sudo-junkie/GeoLock/README.md

# GeoLock

KiCad 7 design files (schematic, PCB, BOM, gerbers) for an STM32F103-based car tracker with the following features:

-	USB-C - firmware upload & debugging
-	Relay - for engine cutout
-	NEO-6M GPS - location tracking
-	SIM800C GSM - for text-based killswitch and location reporting
-	SD Card - location logging and saving persistent settings/data

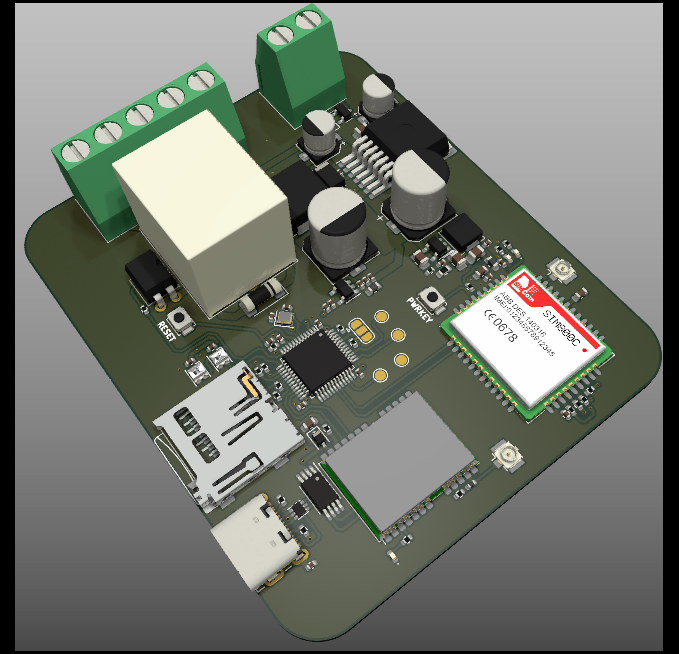
[picture p1: IMAGES/GeoLock5.png]


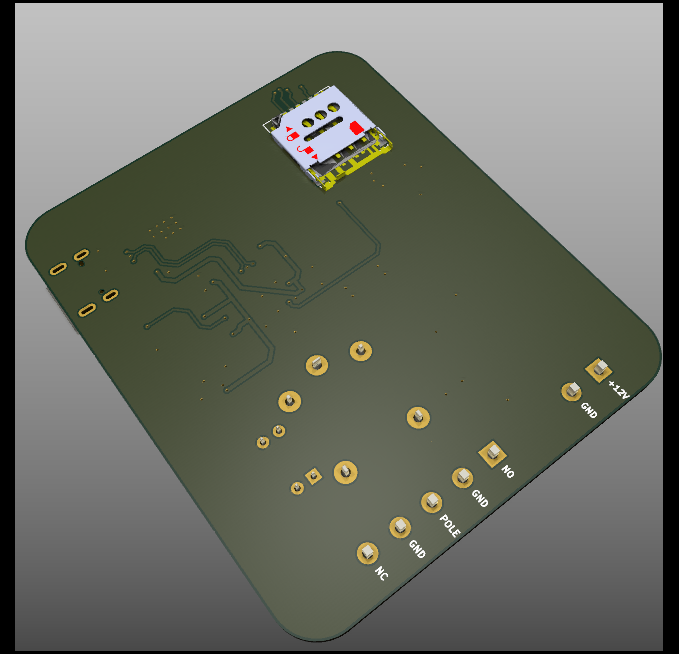
[picture p2: IMAGES/GeoLock6.png]


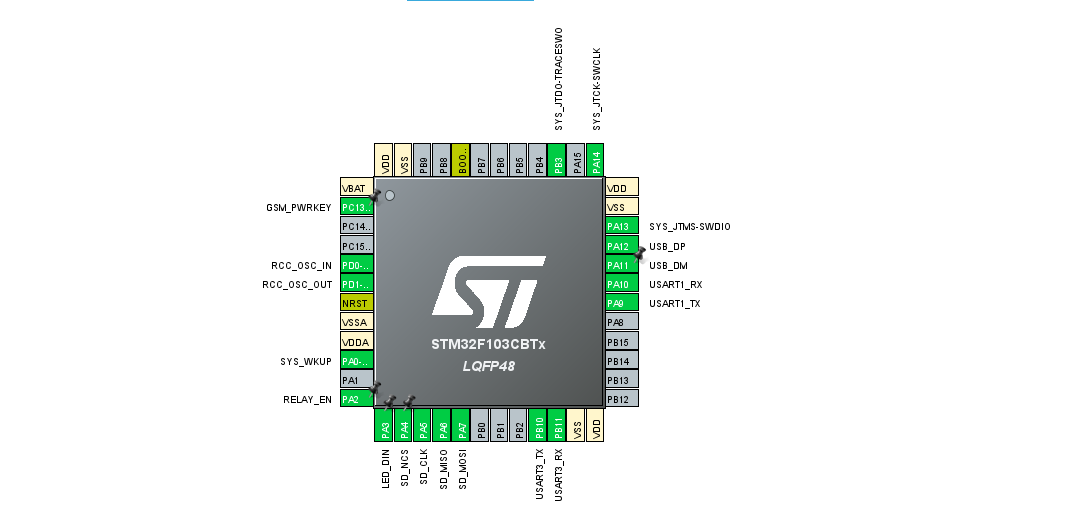
[picture p3: IMAGES/GeoLock_CubeMX.png]
