sudo-junkie/GeoLock/IMAGES/GeoLock2.png

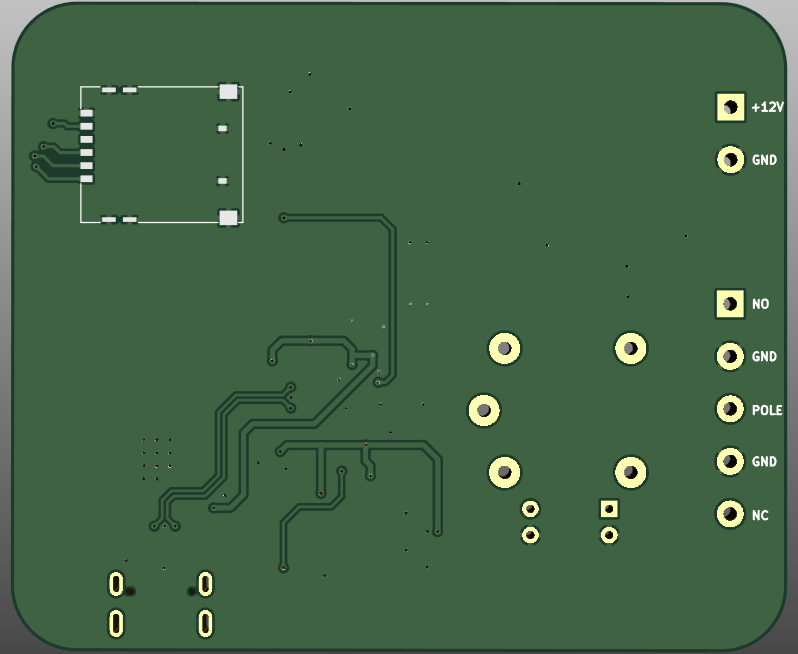
IMAGES/GeoLock2.png
