sudo-junkie/GeoLock/IMAGES/GeoLock3.png

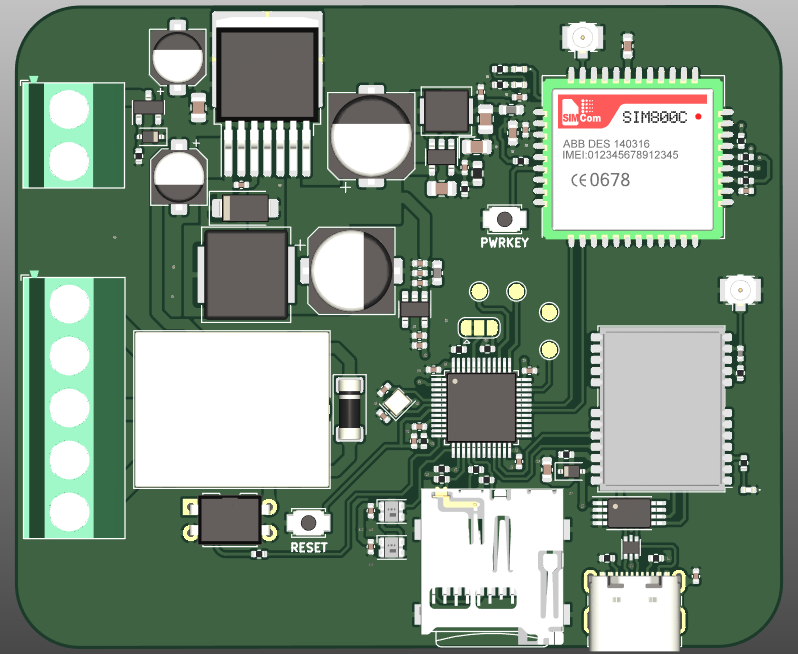
IMAGES/GeoLock3.png
