sudo-junkie/GeoLock/IMAGES/GeoLock4.png

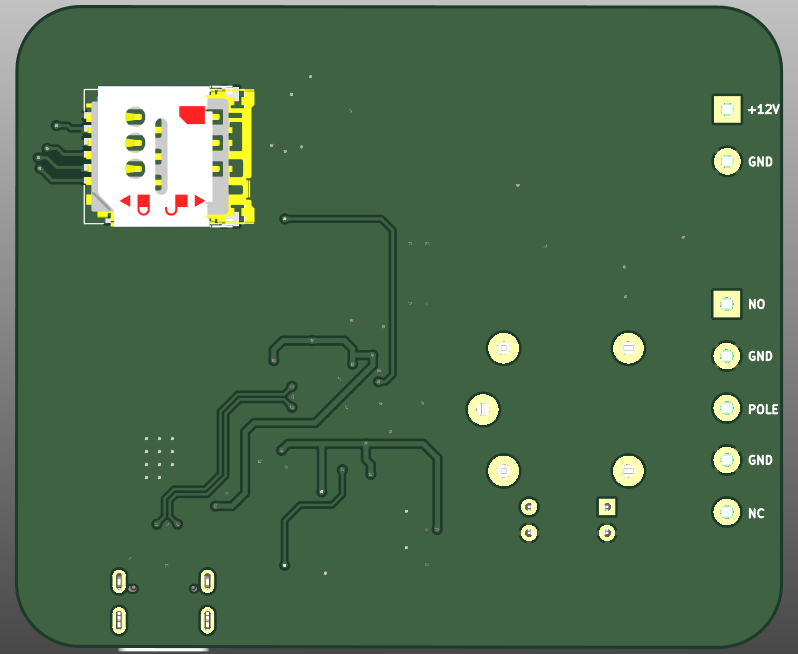
IMAGES/GeoLock4.png
