sudo-junkie/GeoLock/IMAGES/GeoLock7.png

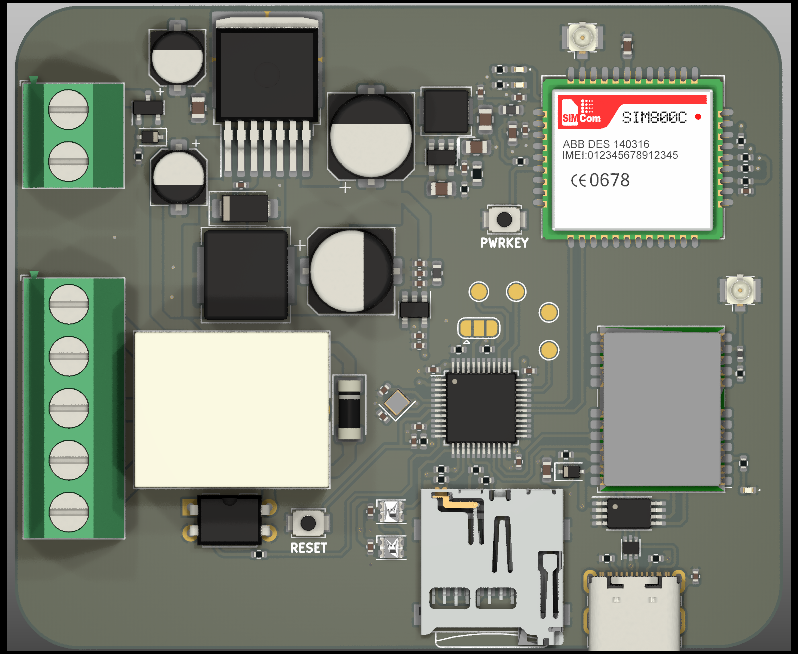
IMAGES/GeoLock7.png
