sudo-junkie/GeoLock/IMAGES/GeoLock8.png

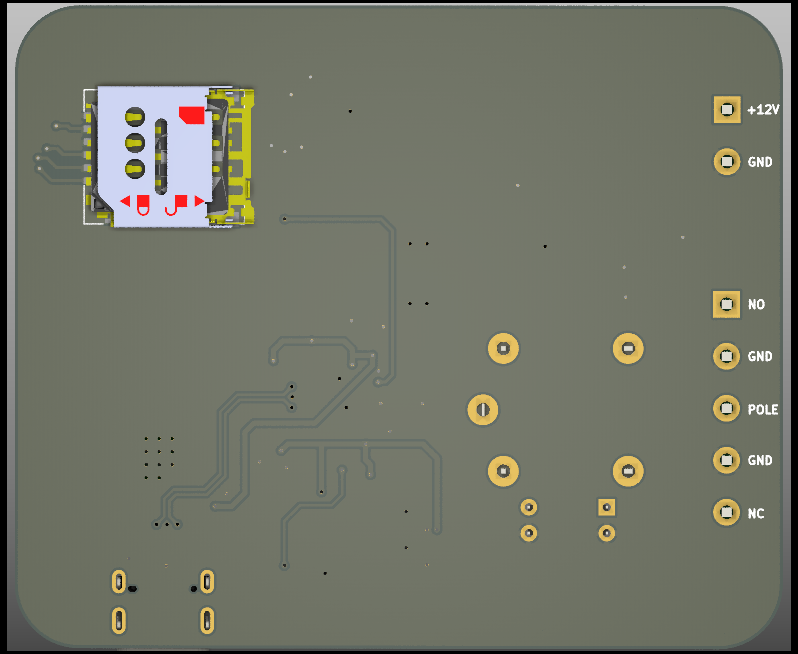
IMAGES/GeoLock8.png
