sudo-junkie/GeoLock/IMAGES/GeoLock.png

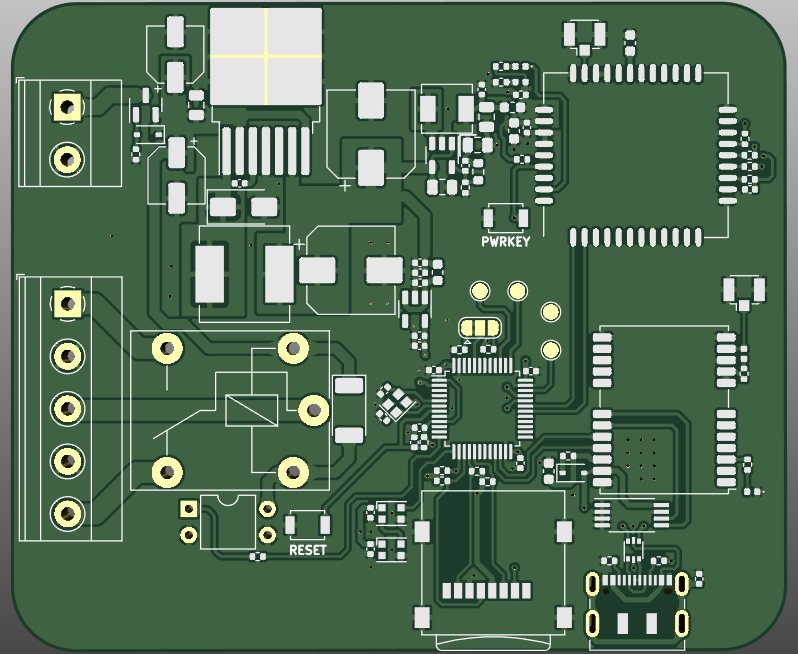
IMAGES/GeoLock.png
