sudo-junkie/GeoLock/SRC/GeoLock.kicad_pcb

## KiCad design SRC/GeoLock.kicad_pcb (2023-06-28)

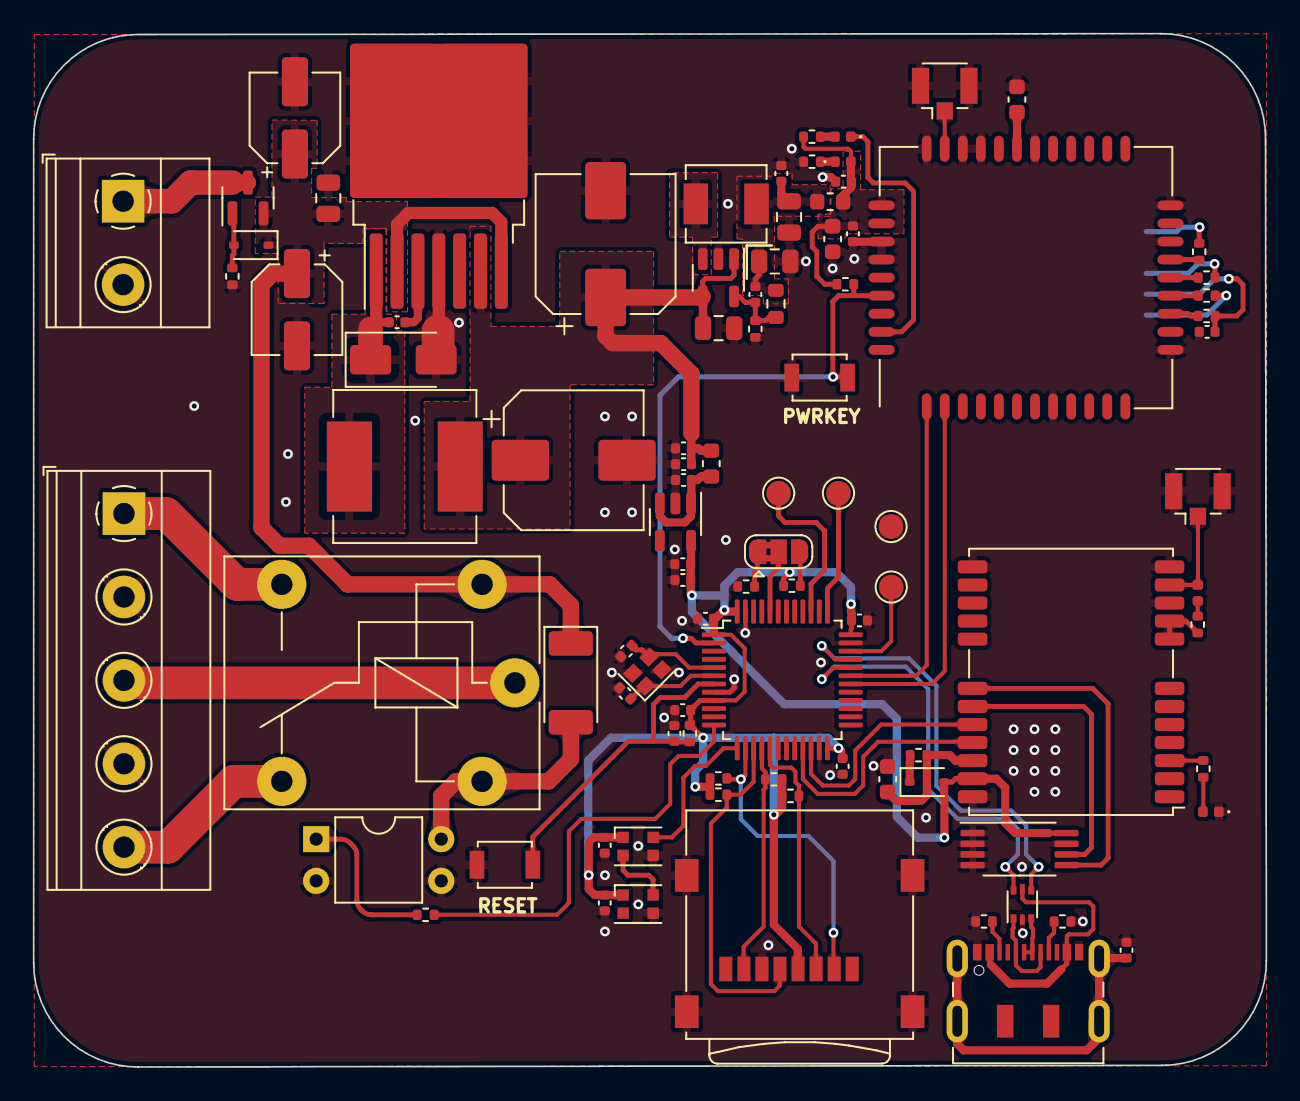
[picture p16: board GeoLock.kicad_pcb from above]

Board: 2 copper layers, 75.1 x 62.9 mm, 95 parts (1 on the bottom side), 69 nets.

Parts:
C101, C207, C409, C410, C508, C509, C510: 1u 10% 10V X5R; C_0402_1005Metric
C203: 10u 20% 10V X5R; C_0402_1005Metric
C204, C205, C206, C210, C211, C404, C507, C511: 100n 10V 5%; C_0402_1005Metric
C208, C209: 22p 1% NP0 50V; C_0402_1005Metric
C401, C403, C601: 100u 20% 6.3V; C_0603_1608Metric
C402, C408: 8p ±1% 50V C0G; C_0402_1005Metric
C405, C406, C407: 22u 20% X5R 16V; C_0805_2012Metric
C501: 10n 5% 16V X7R; C_0402_1005Metric
C502, C503: 22u 20% 50V; CP_Elec_5x5.8
C504: 470n 5% 50V X7R; C_0805_2012Metric
C505, C506: 180u 20% 50V; CP_Elec_8x10
D101: 11V; D_SOD-323
D201, D202: WS2812B; LED_WS2812B-2020_PLCC4_2.0x2.0mm
D301: SM4001; D_MELF
D401: GSM_PWR; LED_0402_1005Metric
D402: GSM_NET; LED_0402_1005Metric
D501: SS54; D_SMA
D601: SD103AWS; D_SOD-323
D602: LED_GPS; LED_0402_1005Metric
FB401, FB501: 220R @ 100MHz 3A; L_0603_1608Metric
J101: Conn_VIN; TerminalBlock_Phoenix_MKDS-1,5-2-5.08_1x02_P5.08mm_Horizont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
J102: Conn_CUTOUT; TerminalBlock_Phoenix_MKDS-1,5-5-5.08_1x05_P5.08mm_Horizont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
J103: USB_C_Receptacle_USB2.0; USB_C_Receptacle_JAE_DX07S016JA1R1500
J201: Micro_SD_Card; microSD_HC_Wuerth_693072010801
J401: SIM_Card; microSIM_JAE_SF53S006VCBR2000
J402: Conn_GSM; U.FL_Hirose_U.FL-R-SMT-1_Vertical
J601: Conn_GPS; U.FL_Hirose_U.FL-R-SMT-1_Vertical
JP201: JP_BOOT; SolderJumper-3_P1.3mm_Bridged2Bar12_RoundedPad1.0x1.5mm
K301: FINDER-36.11; Relay_SPDT_Finder_36.11
L401: 2u2; L_Sunlord_MWSA0402S
L501: 22u; L_Sunlord_MWSA0804S
L601: 22u; L_0402_1005Metric
Q101: AO3401A; SOT-23
R101, R201, R202, R203, R204, R205, R206, R207, R407: 10K 0.1%; R_0402_1005Metric
R102, R103: 5K1 0.1%; R_0402_1005Metric
R301, R602: 1K 0.1%; R_0402_1005Metric
R401: 330K 0.1%; R_0603_1608Metric
R402: 56K 0.1%; R_0402_1005Metric
R403, R404, R405, R406: 51R 0.1%; R_0402_1005Metric
R408, R603: 4k7 0.1%; R_0402_1005Metric
R409: 4K7 0.1%; R_0402_1005Metric
R601: 22R 0.1%; R_0402_1005Metric
SW201: SW_RST; SW_SPST_B3U-1000P
SW401: GSM_PWR; SW_SPST_B3U-1000P
TP201: TP_SWCLK; TestPoint_Pad_D1.5mm
TP202: TP_GND; TestPoint_Pad_D1.5mm
TP203: TP_SWO; TestPoint_Pad_D1.5mm
TP204: TP_SWDIO; TestPoint_Pad_D1.5mm
U101: USBLC6-2P6; SOT-666
U201: STM32F103CBTx; LQFP-48_7x7mm_P0.5mm
U301: PC817; DIP-4_W7.62mm
U401: SY8089; SOT-23-5
U402: SIM800C; SIMCom_SIM800C
U501: LM2678-5.0; TO-263-7_TabPin8
U502: TLV75733PDBV; SOT-23-5
U601: NEO-6x; ublox_NEO
U602: 24LC32; TSSOP-8_4.4x3mm_P0.65mm
Y201: 16MHz; Crystal_SMD_2016-4Pin_2.0x1.6mm

Connections:
+3V3: C203.1, C204.1, C205.1, C206.1, C210.1, C211.1, C510.1, C511.1, D201.1 (VDD), D202.1 (VDD), D601.2 (A), J201.4 (VDD), R201.1, R202.1, R203.1, R204.1, R205.1, R206.1, U201.1 (VBAT), U201.9 (VDDA), U201.24 (VDD), U201.36 (VDD), U201.48 (VDD), U502.5 (OUT), U601.23 (VCC), U602.8 (VCC)
+4V: C403.2, C404.1, C410.1, D401.2 (A), FB401.1, R407.1, R408.2, U402.34 (VBAT), U402.35 (VBAT)
+5V: C405.1, C505.1, C506.1, C507.1, C508.1, FB501.1, L501.2, U401.1 (EN), U401.4 (VIN), U501.6 (FB)
+12V: C502.1, C503.1, C504.1, D101.1 (K), D301.1 (K), K301.A1, Q101.2 (S), U501.2 (VIN), U501.7 (EN)
/D+: J103.A6 (D+), J103.B6 (D+), U101.3 (I/O2)
/D-: J103.A7 (D-), J103.B7 (D-), U101.1 (I/O1)
/GeoLock_Power/SW_5V: C501.2, D501.1 (K), L501.1, U501.1 (SW)
/MCU_ST_STM32F103CBTx/BOOT0: JP201.2 (C), U201.44 (BOOT0)
/MCU_ST_STM32F103CBTx/HOSC1: C208.1, U201.5 (PD0), Y201.3
/MCU_ST_STM32F103CBTx/HOSC2: C209.1, U201.6 (PD1), Y201.1
/MCU_ST_STM32F103CBTx/LED_DIN: D201.4 (DIN), U201.13 (PA3)
/MCU_ST_STM32F103CBTx/NRST: C207.1, R201.2, SW201.2, U201.7 (NRST)
/MCU_ST_STM32F103CBTx/RELAY_EN: R301.1, U201.12 (PA2)
/MCU_ST_STM32F103CBTx/SD_CLK: J201.5 (CLK), R203.2, U201.15 (PA5)
/MCU_ST_STM32F103CBTx/SD_MISO: J201.7 (DAT0), R204.2, U201.16 (PA6)
/MCU_ST_STM32F103CBTx/SD_MOSI: J201.3 (CMD), R205.2, U201.17 (PA7)
/MCU_ST_STM32F103CBTx/SD_NCS: J201.2 (DAT3/CD), R202.2, U201.14 (PA4)
/MCU_ST_STM32F103CBTx/SWCLK: TP201.1, U201.37 (PA14)
/MCU_ST_STM32F103CBTx/SWDIO: TP204.1, U201.34 (PA13)
/MCU_ST_STM32F103CBTx/SWO: TP203.1, U201.39 (PB3)
/MCU_ST_STM32F103CBTx/USART1_RX: U201.31 (PA10), U402.1 (UART1_TXD)
/MCU_ST_STM32F103CBTx/USART1_TX: U201.30 (PA9), U402.2 (UART1_RXD)
/MCU_ST_STM32F103CBTx/USART3_RX: U201.22 (PB11), U601.20 (TXD1)
/MCU_ST_STM32F103CBTx/USART3_TX: U201.21 (PB10), U601.21 (RXD1)
/MODULE_RELAY/RELAY_NC: J102.5, K301.12
/MODULE_RELAY/RELAY_NO: J102.1, K301.14
/MODULE_RELAY/RELAY_POLE: J102.3, K301.11
/RF_GPS_NEO6M/GPS_RF: J601.1 (In), L601.2, U601.11 (RF_IN)
/RF_GPS_NEO6M/V_BCKP: C601.2, R602.2, U601.22 (V_BCKP)
/RF_GPS_NEO6M/V_RF: R601.1, U601.8 (VCC_RF), U601.9 (VCC_RF)
/RF_GSM_SIM800C/4V_OUT: C402.1, C406.1, C407.1, C409.1, FB401.2, L401.2, R401.1
/RF_GSM_SIM800C/4V_SW: L401.1, U401.3 (LX)
/RF_GSM_SIM800C/GSM_RF: J402.1 (In), U402.32 (GSM_ANT)
/RF_GSM_SIM800C/NETLIGHT: D402.1 (K), U402.41 (NETLIGHT)
/RF_GSM_SIM800C/PWRKEY: R407.2, SW401.1, U201.2 (PC13), U402.39 (~PWRKEY)
/RF_GSM_SIM800C/SIM_CLK: J401.3 (CLK), R405.2
/RF_GSM_SIM800C/SIM_DIO: C408.2, J401.7 (I/O), R404.2
/RF_GSM_SIM800C/SIM_RST: J401.2 (RST), R406.2
/RF_GSM_SIM800C/VSIM: J401.1 (VCC), R403.2
/USB_DN: U101.6 (I/O1), U201.32 (PA11)
/USB_DP: U101.4 (I/O2), U201.33 (PA12)
Earth: C101.1, J103.S1 (SHIELD)
GND: C101.2, C203.2, C204.2, C205.2, C206.2, C207.2, C208.2, C209.2, C210.2, C211.2, C401.1, C403.1, C404.2, C405.2, C406.2, C407.2, C408.1, C409.2, C410.2, C502.2, C503.2, C504.2, C505.2, C506.2, C507.2, C508.2, C509.2, C510.2, C511.2, C601.1, D201.3 (VSS), D202.3 (VSS), D501.2 (A), D602.1 (K), J101.2, J102.2, J102.4, J103.A1 (GND), J103.A12 (GND), J103.B1 (GND), J103.B12 (GND), J201.6 (VSS), J201.9 (SHIELD), J401.5 (GND), J401.SH, J402.2 (Ext), J601.2 (Ext), R101.2, R102.2, R103.2, R207.2, R402.2, R409.2, SW201.1, SW401.2, TP202.1, U101.2 (GND), U201.8 (VSSA), U201.23 (VSS), U201.35 (VSS), U201.47 (VSS), U301.2, U301.3, U401.2 (GND), U402.8 (GND), U402.13 (GND), U402.19 (GND), U402.21 (GND), U402.27 (GND), U402.30 (GND), U402.31 (GND), U402.33 (GND), U402.36 (GND), U402.37 (GND), U501.4 (GND), U501.8 (GND), U502.2 (GND), U601.10 (GND), U601.12 (GND), U601.13 (GND), U601.24 (GND), U602.1 (A0), U602.2 (A1), U602.3 (A2), U602.4 (GND), U602.7 (WP), Y201.2, Y201.4
unnamed: D101.2 (A), Q101.1 (G), R101.1
unnamed: D201.2 (DOUT), D202.4 (DIN)
unnamed: D301.2 (A), K301.A2, U301.4
unnamed: D401.1 (K), R409.1
unnamed: D402.2 (A), R408.1
unnamed: D601.1 (K), R602.1
unnamed: D602.2 (A), R603.1
unnamed: J101.1, Q101.3 (D)
unnamed: J103.A5 (CC1), R102.1
unnamed: J103.B5 (CC2), R103.1
unnamed: JP201.1 (A), R207.1
unnamed: JP201.3 (B), R206.2
unnamed: L601.1, R601.2
unnamed: R301.2, U301.1
unnamed: C402.2, R401.2, R402.1, U401.5 (FB)
unnamed: R405.1, U402.16 (SIM_CLK)
unnamed: R404.1, U402.15 (SIM_DATA)
unnamed: R406.1, U402.17 (SIM_RST)
unnamed: R403.1, U402.18 (SIM_VDD)
unnamed: C401.2, U402.28 (VRTC)
unnamed: C501.1, U501.3 (BOOST)
unnamed: C509.1, FB501.2, U502.1 (IN), U502.3 (EN)
unnamed: U601.19 (SCL2), U602.6 (SCL)
unnamed: U601.18 (SDA2), U602.5 (SDA)
unnamed: R603.2, U601.3 (TIMEPULSE)
VBUS: J103.A4 (VBUS), J103.A9 (VBUS), J103.B4 (VBUS), J103.B9 (VBUS), U101.5 (VBUS)
