sudo-junkie/GeoLock/ASSETS/GeoLock.ioc

Mcu.UserName=STM32F103CBTx
PA0-WKUP.Signal=SYS_WKUP
PA10.Signal=USART1_RX
PA11.Signal=USB_DM
PA12.Signal=USB_DP
PA13.Signal=SYS_JTMS-SWDIO
PA14.Signal=SYS_JTCK-SWCLK
PA2.GPIO_Label=RELAY_EN
PA2.Signal=GPIO_Output
PA3.GPIO_Label=LED_DIN
PA3.Signal=GPIO_Output
PA4.GPIO_Label=SD_NCS
PA4.Signal=GPIO_Output
PA5.GPIO_Label=SD_CLK
PA5.Signal=SPI1_SCK
PA6.GPIO_Label=SD_MISO
PA6.Signal=SPI1_MISO
PA7.GPIO_Label=SD_MOSI
PA7.Signal=SPI1_MOSI
PA9.Signal=USART1_TX
PB10.Signal=USART3_TX
PB11.Signal=USART3_RX
PB3.Signal=SYS_JTDO-TRACESWO
PC13-TAMPER-RTC.GPIO_Label=GSM_PWRKEY
PC13-TAMPER-RTC.Signal=GPIO_Output
PD0-OSC_IN.Signal=RCC_OSC_IN
PD1-OSC_OUT.Signal=RCC_OSC_OUT
